milkovwadim/project_test/prosthesis/cyber/stl/organic_leg_full.stl

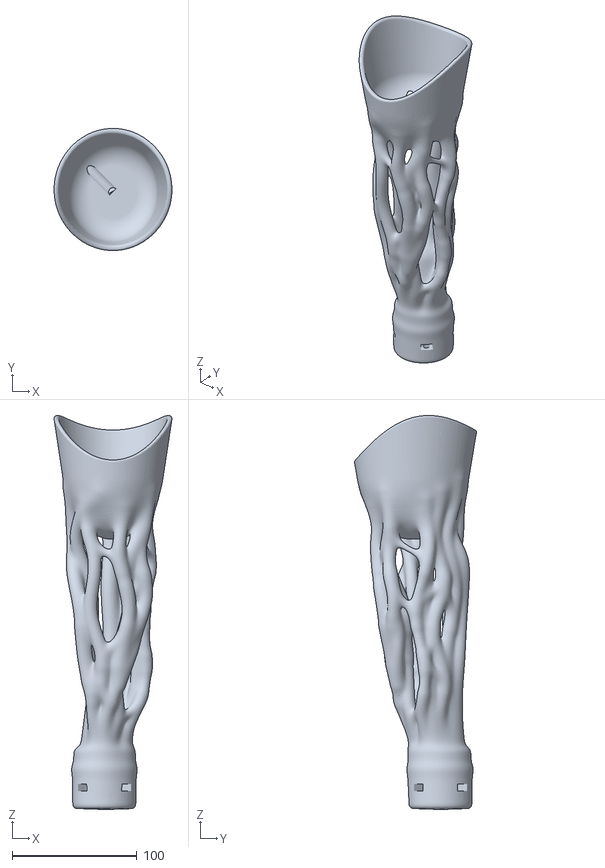
[picture p11: CAD file, 2026-10-23]
prosthesis/cyber/stl/organic_leg_full.stl
94.5 x 97.9 x 315.8
