milkovwadim/project_test/prosthesis/stl/prosthesis_full.stl

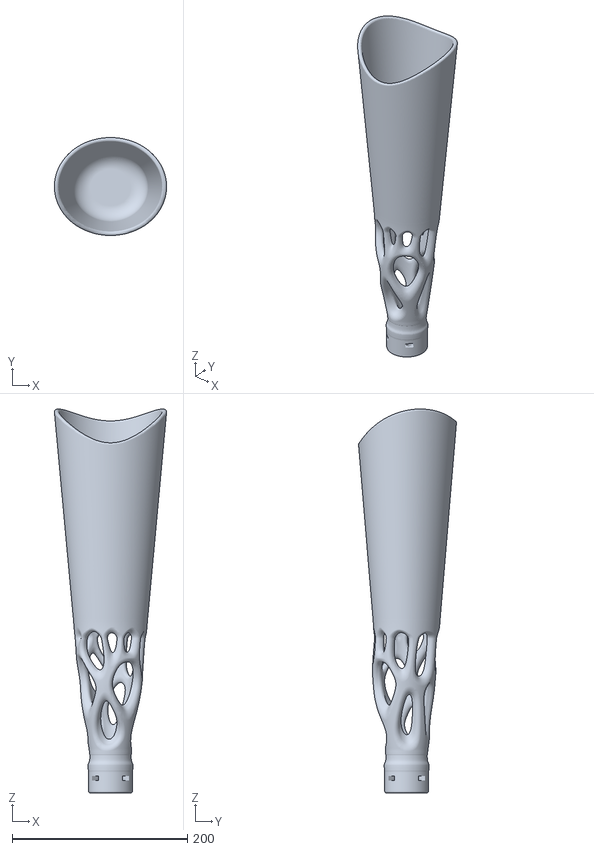
[picture p12: CAD file, 2026-10-01]
prosthesis/stl/prosthesis_full.stl
128.1 x 111.8 x 438.6
