milkovwadim/project_test/prosthesis/stl/prosthesis_part1_socket.stl

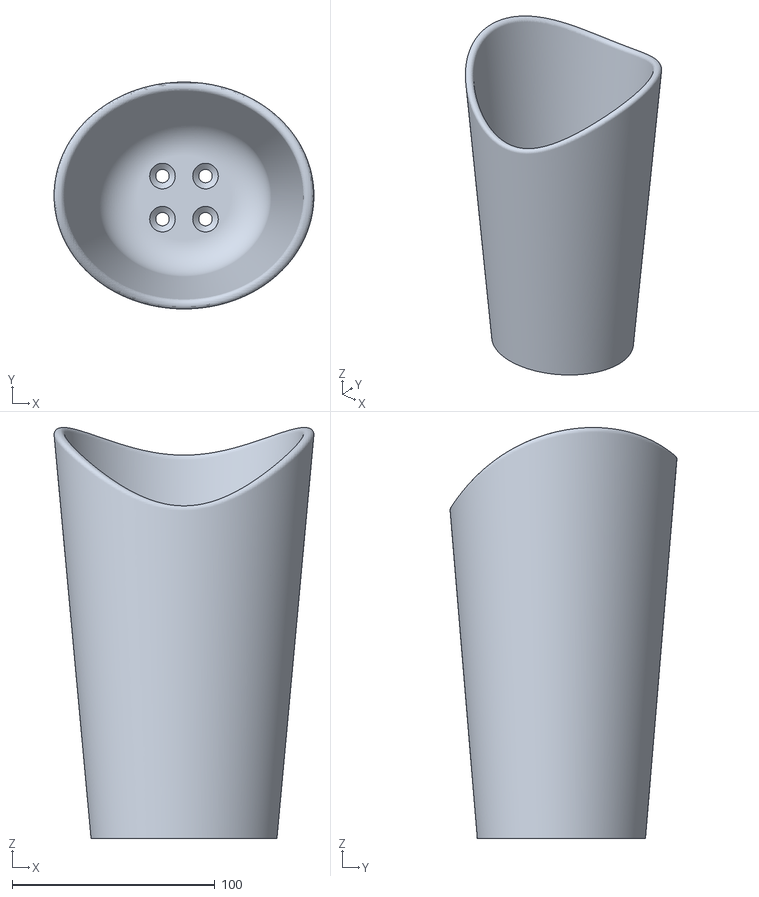
[picture p13: CAD file, 2026-10-01]
prosthesis/stl/prosthesis_part1_socket.stl
128.1 x 111.8 x 202.6
