milkovwadim/project_test/prosthesis/stl/prosthesis_part2_pylon.stl

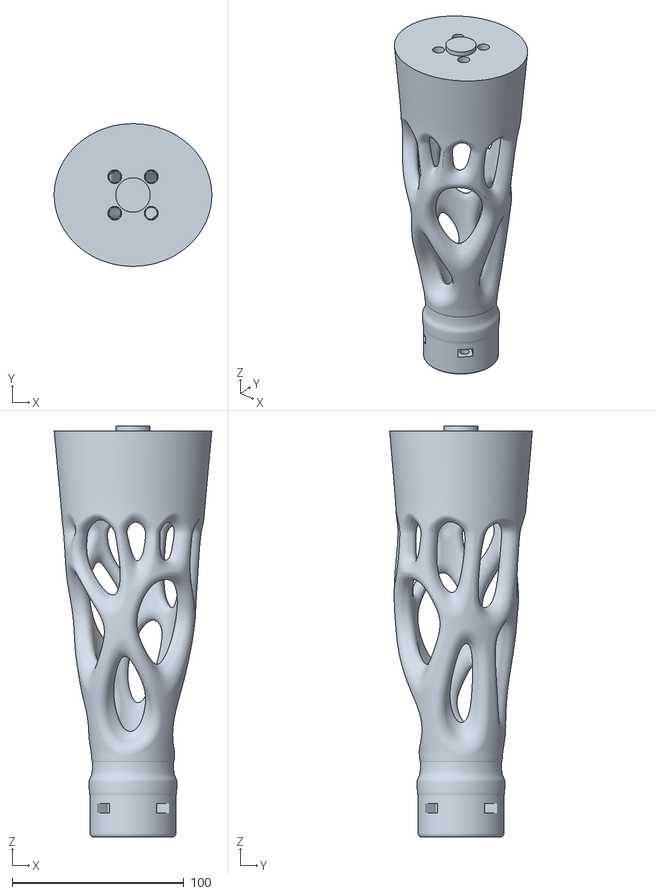
[picture p14: CAD file, 2026-10-01]
prosthesis/stl/prosthesis_part2_pylon.stl
91.7 x 82.9 x 239.0
