milkovwadim/project_test/(commit log)

2026-10-01 Add parametric 3D model of a transtibial prosthesis with an organic openwork shank
    - generate_prosthesis.py: SDF-based generator (socket + perforated leg-shaped
    shell with randomized Voronoi windows + ankle block), marching cubes,
    decimation and exact manifold3d booleans for M6 adapter holes, nut slots
    and the bolted socket/shank joint; all sizes are CLI parameters
    - stl/: one-piece model and a two-part version (socket 203 mm, shank 239 mm),
    plus info.json with dimensions, mass and a bending-section profile
    - README.md (Russian): safety notes, parts list, fitting measurements,
    printing and assembly instructions; images/ with renders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
    [prosthesis_full.stl, prosthesis_part1_socket.stl, prosthesis_part2_pylon.stl]
2026-10-22 WIP: anatomical organic prosthesis variant (real right-leg anatomy, reference style)
    - cyber/anatomy_tubes.py: turns BodyParts3D lower-leg muscles into tube paths
    that follow each muscle's real cross-sections
    - cyber/build_cyber_leg.py: cable-bundle variant (hundreds of thin tubes,
    clamps, ankle housing); provides socket and around-socket deformation
    - cyber/build_organic_leg.py: ~60/40 blend of the reference style and real
    anatomy: thick smooth branches along muscles and bones, tapered socket
    funnel, smooth-min blending, reference-like ankle with M6 adapter holes
    - cyber/stl/organic_leg_full.stl + renders and README (CC BY-SA attribution)
    - generate_prosthesis.py: optional rounded s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
2026-10-22 Anatomical variant: egg-shaped socket bottom, thinner meandering branches, stem
    - socket shorter; its bottom is an ovoid tangent to the socket cone (no seam),
    with a small round hole and a drain like on the reference
    - branches ~30% thinner, slimmer shank, sinusoidal meander, twisted pairs,
    loose muscle ends tied to neighbours, more bridges
    - smooth tapered stem above the ankle restores the weakest section (~6 cm3)
    Claude-Session: https://claude.ai/code/session_01KbVaFrmBbr8FKb85D8smGo
2026-10-22 Organic leg: sculpted joints and selectable branch layouts
    - Lattice-only Gaussian "sculpt" of the distance field for filleted joints
    (the socket wall is untouched); tangent Bezier Y-forks between branches;
    manifold-preserving simplification instead of decimation.
    - Defaults reproduce the preferred intermediate build (s2).
    - New --layout option keeps the same set of branches but changes how they
    run: anatomy (default), spiral (whole bundle winds around the shank),
    delta (more meander and forks), fan (branches spread evenly around).
    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
2026-10-22 Organic leg: more layout knobs and ten new branch layouts
    Layouts can now set branch count and thickness per muscle, bundle twist,
    three-strand cables, counter-rotating spiral, meander wavelength, tree-like
    taper, fork count, sculpt softness and blend radius. Adds web, ropes,
    tornado, cables, weave, strings, tree, snakes, athlete and molten.
    The default layout still reproduces the preferred s2 build exactly.
    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
2026-10-22 Organic leg: fix branch-field steps at the socket, retune three layouts
    Branch distance fields are now evaluated at least as far as the socket
    blend radius, so thin branches no longer leave a small step where their
    evaluation box ends. Cables get tight three-strand ropes with crisp grooves;
    athlete and molten keep more open windows.
    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
2026-10-22 Organic leg: contrast layout (dense calf web, two front struts)
    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
2026-10-22 Organic leg: branches climb the socket so it reads as one piece
    Branches no longer stop at a ring around the bottom of the socket: from
    where they land they continue up the socket as relief, each at its
    anatomical place and to its own height, tapering and sinking into the
    wall. The relief blends into the wall with a tighter radius, and the stump
    cavity is cut afterwards so nothing intrudes into it. The bottom of the
    egg can also be carved by the lattice windows (solid egg, arched window
    tops from a distance transform). Both are layout options (climb, carve),
    on by default.
    Claude-Session: https://claude.ai/code/session_01KbVaFrmBbr8FKb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
2026-10-22 Organic leg: thickness/count scale of layouts, capped socket relief
    Ten layouts from a few very thick branches (closest to the reference) to
    a gossamer web of dozens of thin strands, plus a mixed one with two heavy
    struts and a web between them. Relief on the socket is capped in
    thickness so heavy branches narrow as they climb instead of bulging.
    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
2026-10-22 Organic leg: cleaner thick layouts, smooth loose-end merges
    - Thick branches sit closer to the socket (hover knob, relief-capped
    layer offset), so the egg no longer swells into a bulge.
    - Layouts choose which bone struts to keep and can lower the stem top.
    - Loose branch ends merge 15-60 mm further along a neighbour as a smooth
    diagonal Y, or converge into the stem when no neighbour is close,
    instead of hooking sideways; bridges between distant branches run
    diagonally instead of as ladder rungs.
    - New "tripod" layout (three heavy trunks with diagonal struts).
    Claude-Session: https://claude.ai/code/session_01KbVaFrmBbr8FKb85D8sm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
2026-10-23 Organic leg: socket starts just below the knee
    The socket used to reach 2-3 cm above the knee joint, so the socket read
    as the thigh and the lattice as the shin. The knee is now located from the
    atlas tibia (top of the tibia minus 6 mm), the front rim sits 12 mm below
    it, and the stump cavity is 56 mm deep, so the whole piece is the shin:
    a short cup under the knee, the calf lattice and the ankle.
    The preferred s2 layout (smooth socket) is now the default; the climbing
    relief stays available as the "anatomy" layout. STL, info and images are
    updated to this build (95 x 98 x 316 mm, one watertight body).
    Claude-Session: https://claude.a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
2026-10-23 Organic leg: no waist between the socket and the calf
    The egg-shaped socket bottom narrows to a point, and the branches rooting
    on it pulled the silhouette in, leaving a waist about 2/3 up the shank
    (55 mm wide between 91 at the rim and 70 at the calf). Below the socket,
    branches now follow the socket cone continued downward until they start
    rooting, and they root higher, on the wide part of the egg, so the width
    falls steadily from the knee to the ankle.
    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
